c6209c6209/Different_Weight_Items_Counter/pictures/IMG_1278.JPG

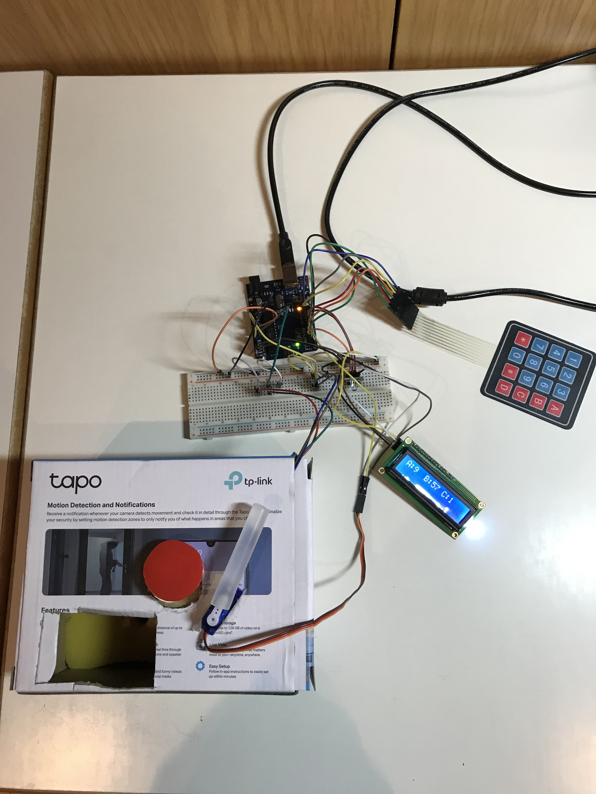
pictures/IMG_1278.JPG
