c6209c6209/Different_Weight_Items_Counter/pictures/IMG_1288.JPG

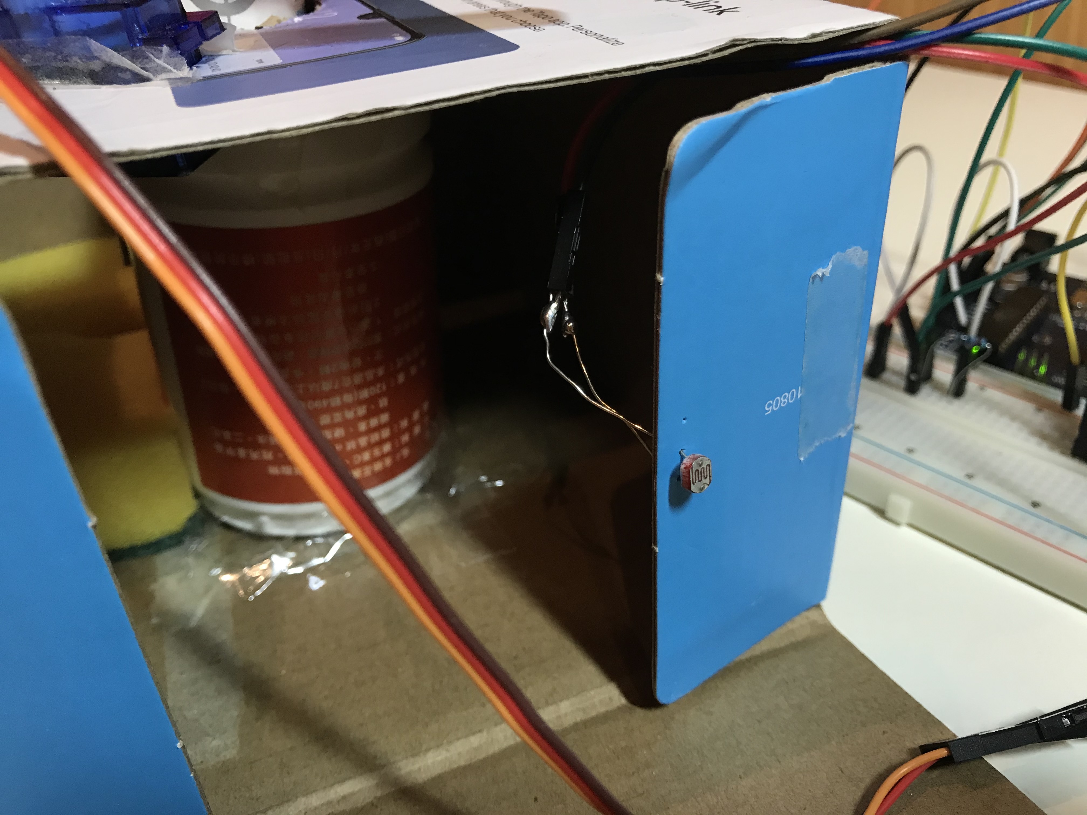
pictures/IMG_1288.JPG
