c6209c6209/Different_Weight_Items_Counter/pictures/IMG_1294.JPG

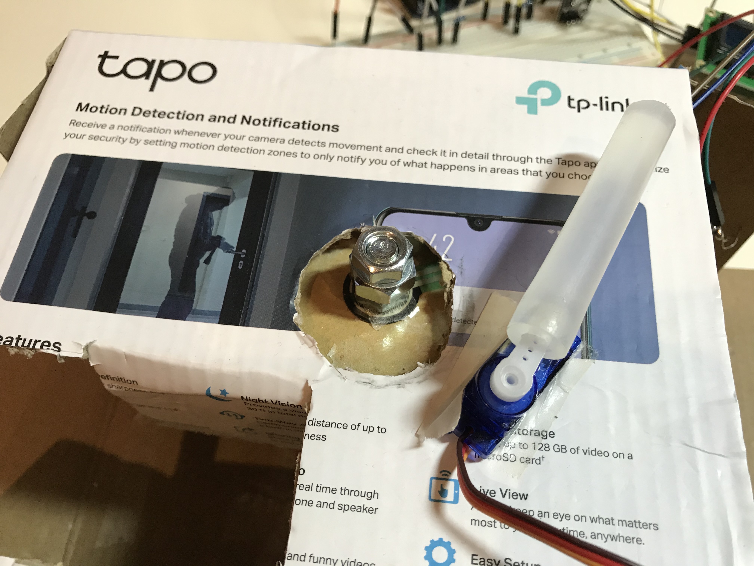
pictures/IMG_1294.JPG
