c6209c6209/Different_Weight_Items_Counter/schematics&flowchart/embedded final flowchart.png

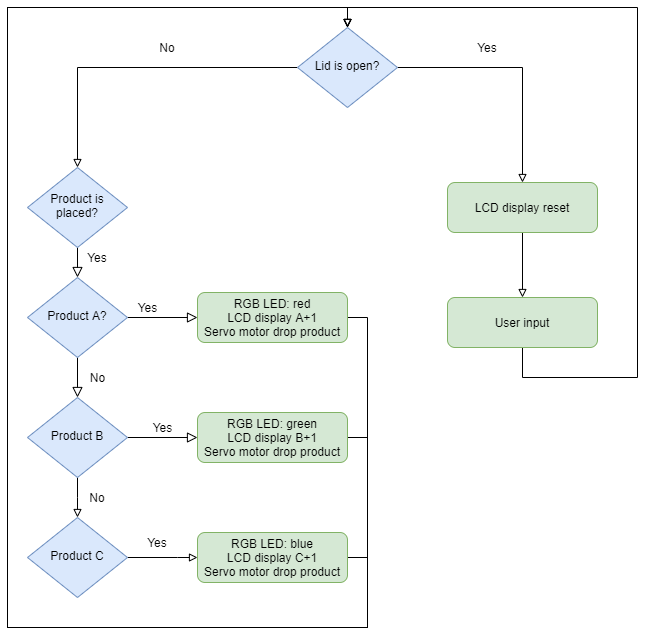
schematics&flowchart/embedded final flowchart.png
