c6209c6209/Different_Weight_Items_Counter/schematics&flowchart/embedded final schematic.png

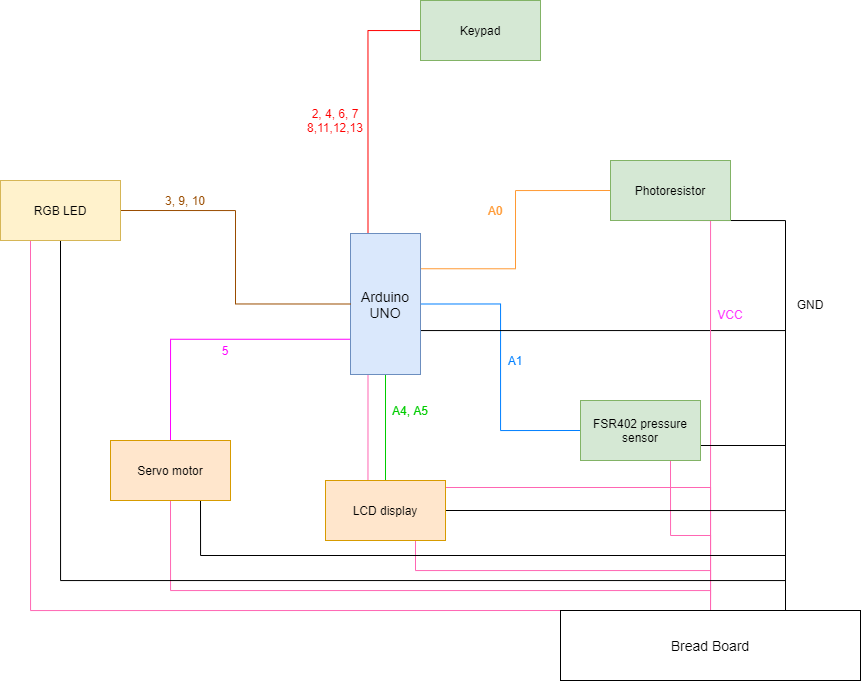
schematics&flowchart/embedded final schematic.png
